toncho11/retro_psu_adapter/Model_AA/images/20261108_110636.jpg

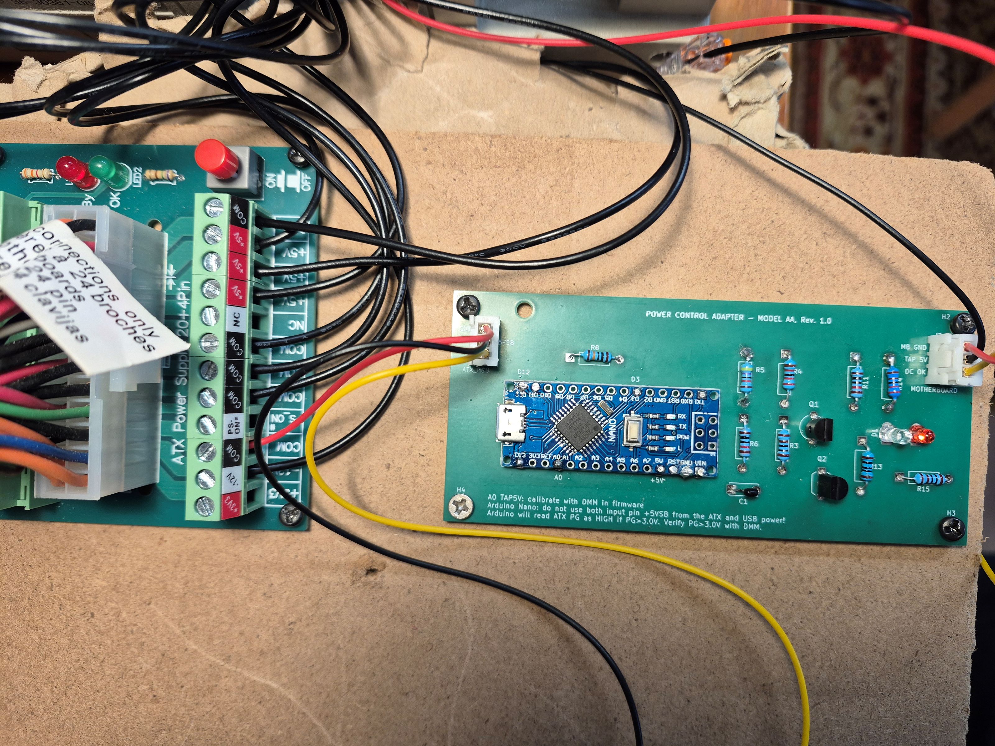
Model_AA/images/20261108_110636.jpg
