toncho11/retro_psu_adapter/Model_AA/kicad/atx_dcok.kicad_pcb

## KiCad design Model_AA/kicad/atx_dcok.kicad_pcb (2026-11-11)

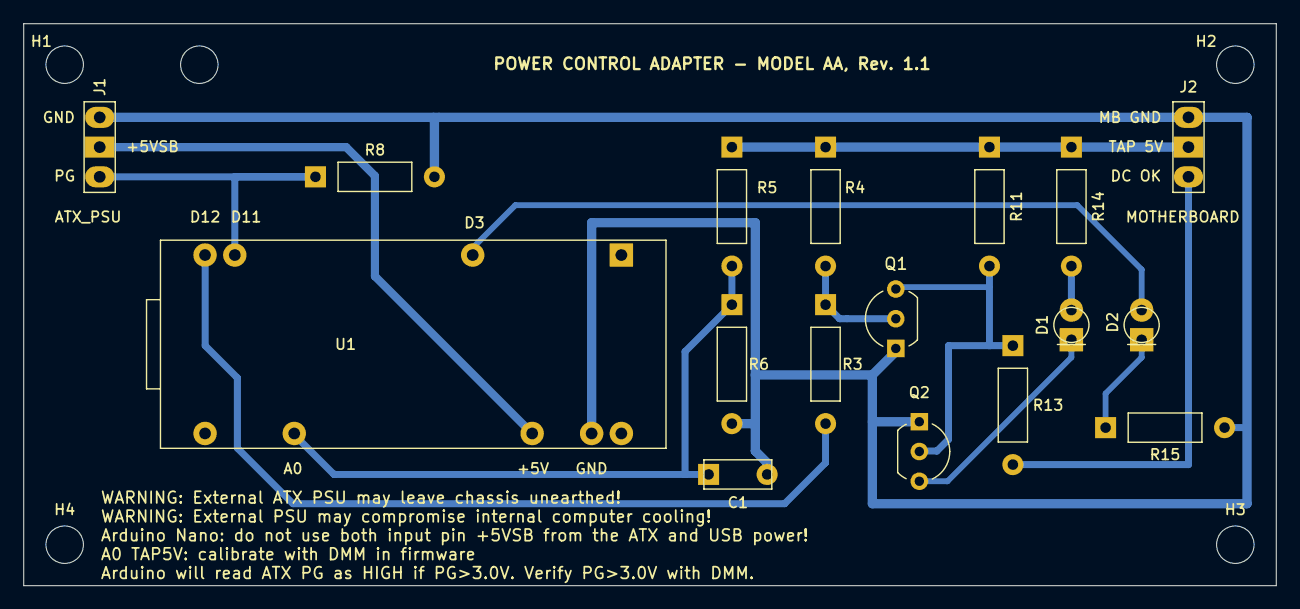
[picture p5: board atx_dcok.kicad_pcb from above]

Board: 2 copper layers, 107.0 x 48.0 mm, 21 parts (0 on the bottom side), 13 nets.

Parts:
C1: 100nF ceramic; C_Disc_D5.0mm_W2.5mm_P5.00mm
D1: GREEN; LED_D3.0mm
D2: RED; LED_D3.0mm
H1, H2, H3, H4: MountingHole; MountingHole_3.2mm_M3
J1: ATX_PSU; PinHeader_1x03_P2.54mm_Vertical
J2: MOTHERBOARD; PinHeader_1x03_P2.54mm_Vertical
Q1: 2N3904; TO-92_Inline_Wide
Q2: 2N7000; TO-92_Inline_Wide
R3, R15: 1k; R_Axial_DIN0207_L6.3mm_D2.5mm_P10.16mm_Horizontal
R4: 22k; R_Axial_DIN0207_L6.3mm_D2.5mm_P10.16mm_Horizontal
R5: 47k 1%; R_Axial_DIN0207_L6.3mm_D2.5mm_P10.16mm_Horizontal
R6: 10k 1%; R_Axial_DIN0207_L6.3mm_D2.5mm_P10.16mm_Horizontal
R8: 100k; R_Axial_DIN0207_L6.3mm_D2.5mm_P10.16mm_Horizontal
R11: 10k; R_Axial_DIN0207_L6.3mm_D2.5mm_P10.16mm_Horizontal
R13: 100; R_Axial_DIN0207_L6.3mm_D2.5mm_P10.16mm_Horizontal
R14: 2.2k; R_Axial_DIN0207_L6.3mm_D2.5mm_P10.16mm_Horizontal
U1: Arduino_Nano_v3.x; Arduino_Nano

Connections:
/+5VSB: J1.1, U1.27
/A0: C1.1, R5.2, R6.1, U1.19
/COLLECTOR: Q1.3, Q2.2, R11.2, R13.1
/D3_RED: D2.2, U1.6
/D12_DRIVE: R3.2, U1.15
/DC_OK: J2.2, R13.2
/LED_A: D1.2, R14.2
/LED_K: D1.1, Q2.3
/PWR_OK: J1.2, R8.1, U1.14
/RED_K: D2.1, R15.1
/TAP_5V: J2.1, R4.1, R5.1, R11.1, R14.1
GND: C1.2, J1.3, J2.3, Q1.1, Q2.1, R6.2, R8.2, R15.2, U1.29
unnamed: Q1.2, R3.1, R4.2
